rohitgarg025/Intelligent-Humidistat/OUTPUT.jpeg

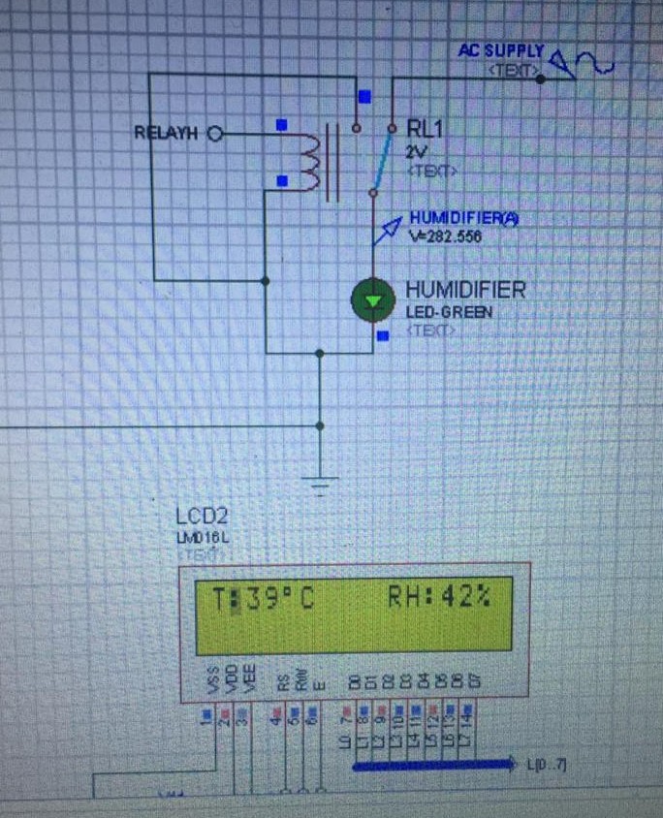
OUTPUT.jpeg
