rohitgarg025/Intelligent-Humidistat/Design.pdf

### Design Components

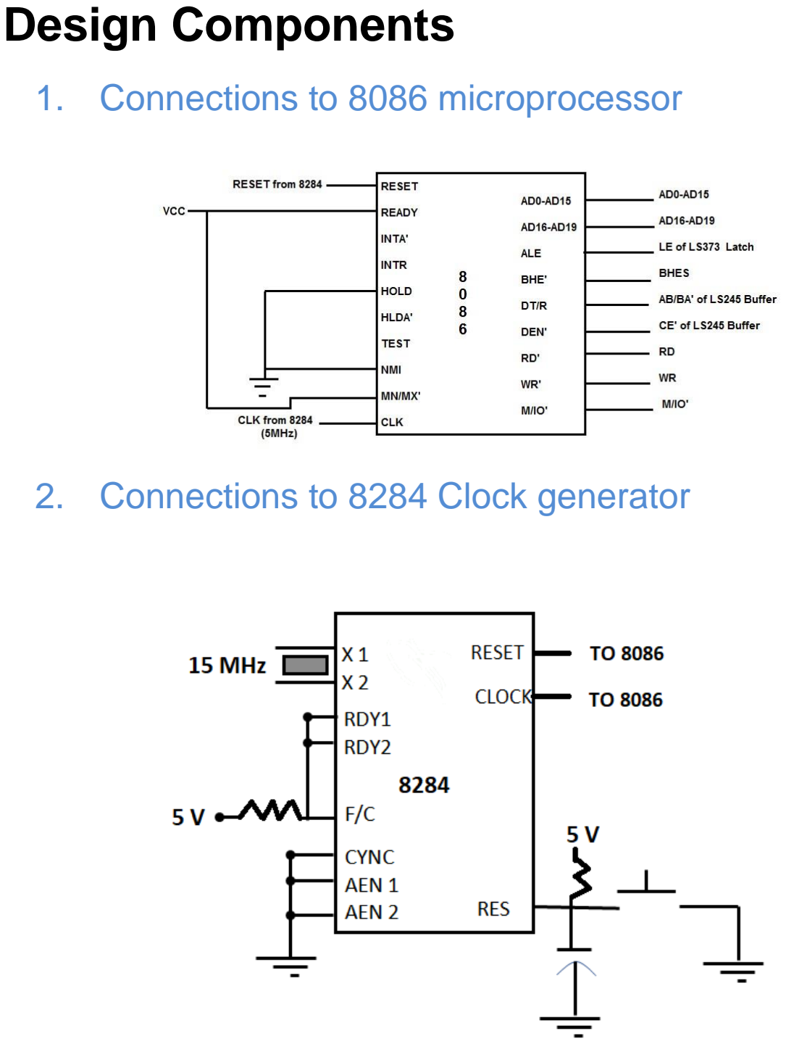
[picture p2: page 1]

1. Connections to 8086 microprocessor
2. Connections to 8284 Clock generator

3. Address Bus : Connections to 74LS373 Octal Latches

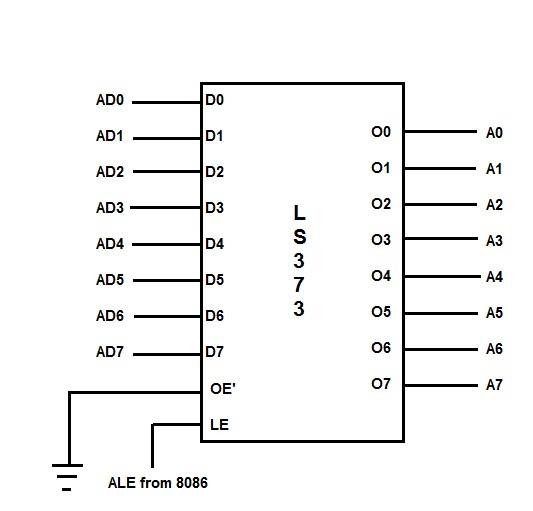
[picture p3: figure]

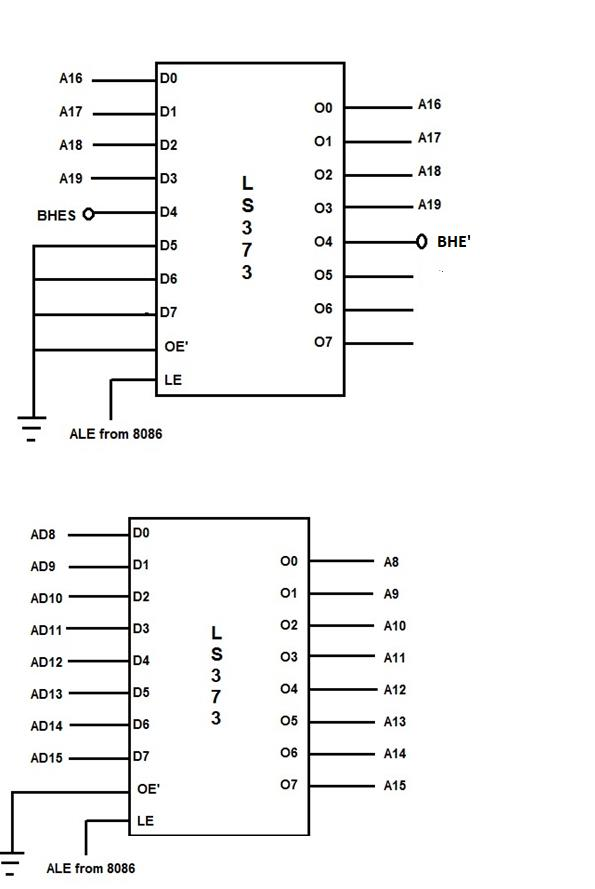
[picture p4: figure]

4. Data Bus : Connections to 74LS245 Octal Buffers

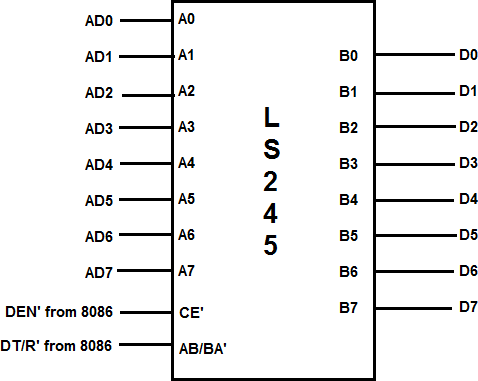
[picture p5: figure]
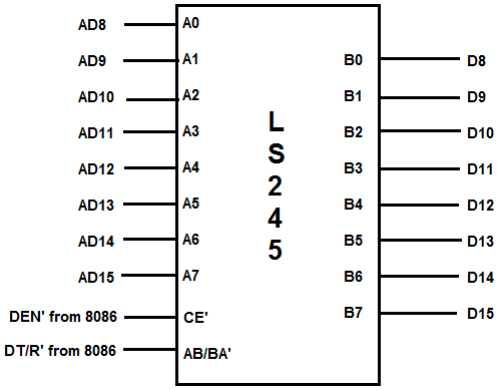
[picture p6: figure]

5. Memory Decoding Logic

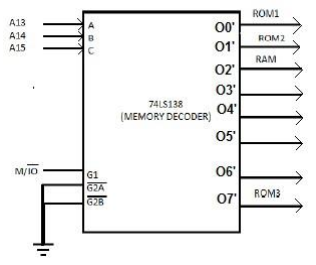
[picture p7: figure]

6. I/O Decoding Logic

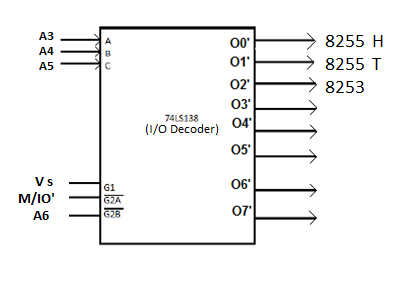
[picture p8: figure]
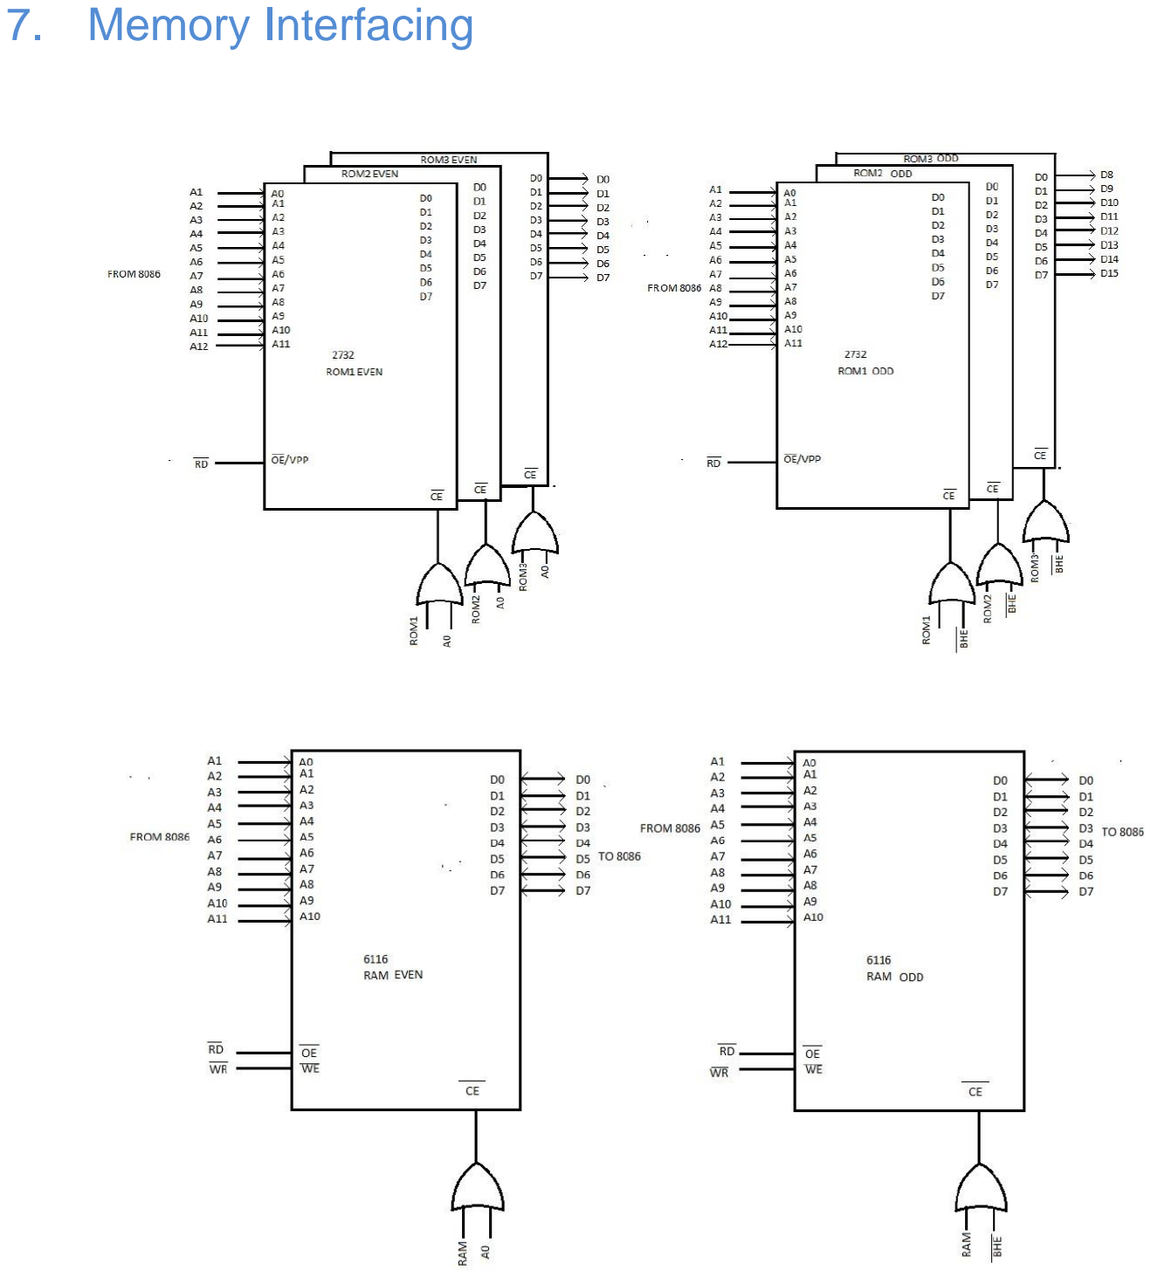
[picture p9: page 6]

7. Memory Interfacing

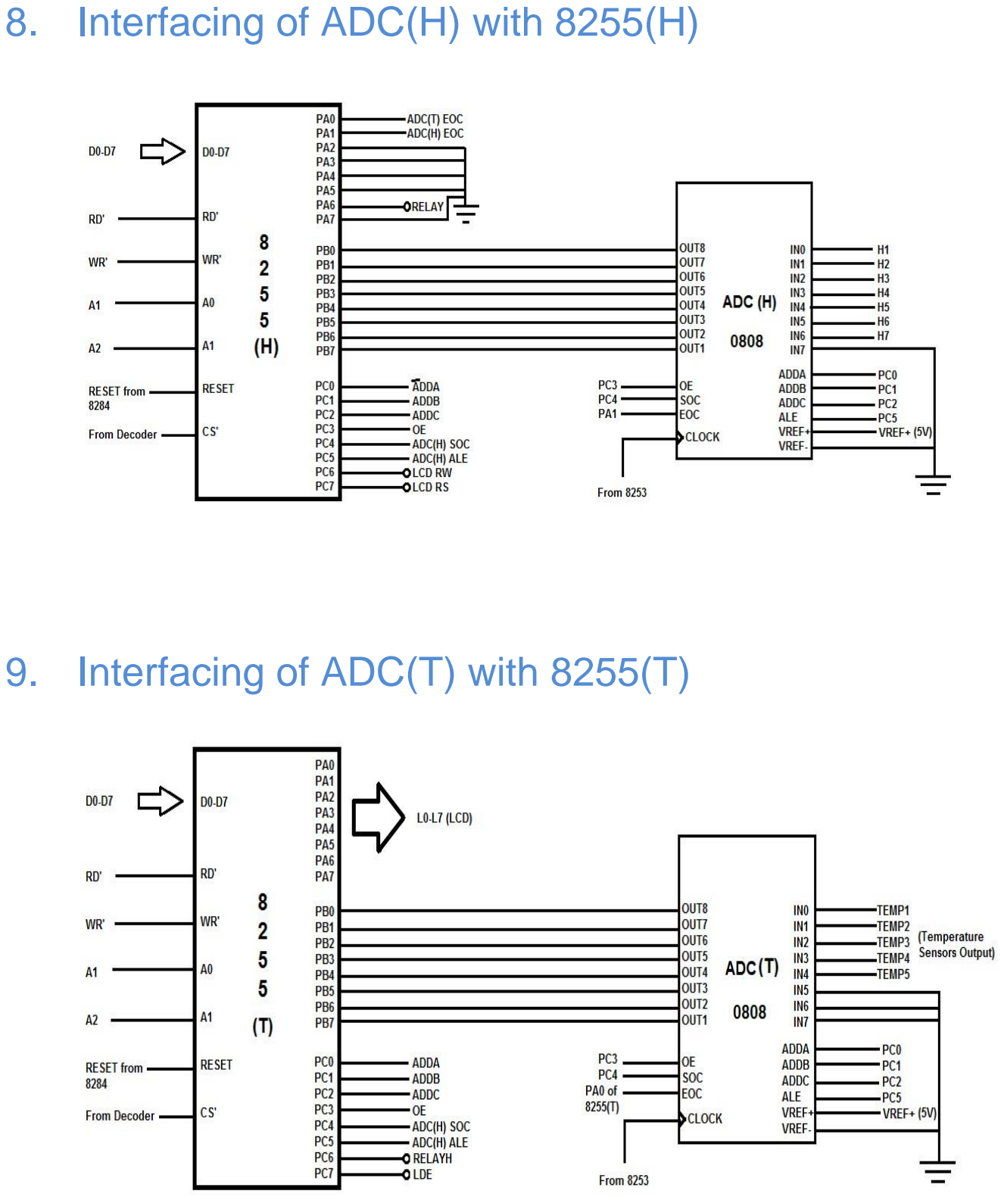
[picture p10: page 7]

8. Interfacing of ADC(H) with 8255(H)
9. Interfacing of ADC(T) with 8255(T)

10. Interfacing of 8253 with ADC0808(T) and ADC0808(H)

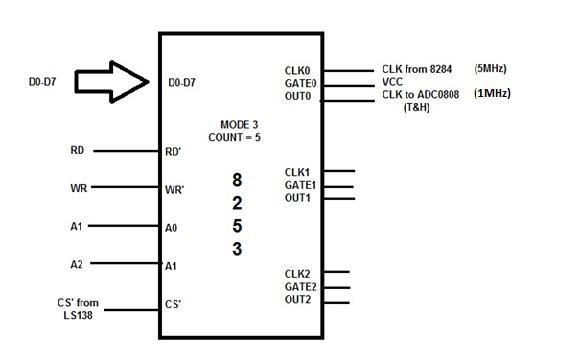
[picture p11: figure]

11. Connections to Temperature sensor LMT85 and Humidity sensor HIH4030

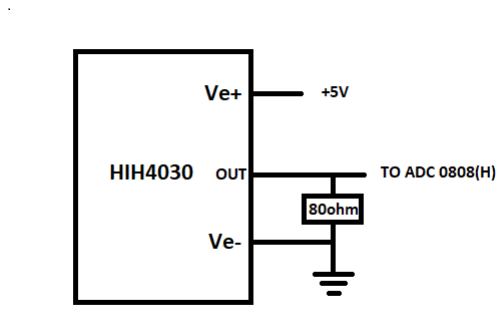
[picture p12: figure]
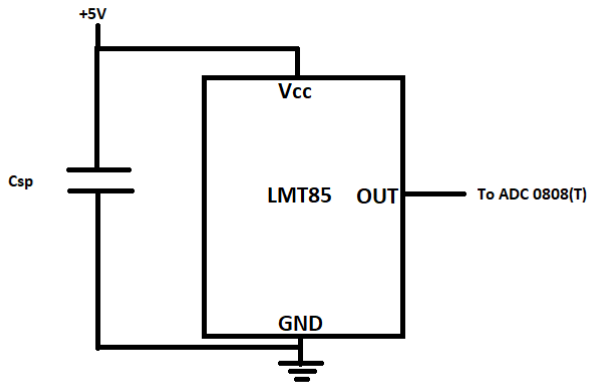
[picture p13: figure]

12. Interfacing of LCD with 8255(H) and 8255 (T)

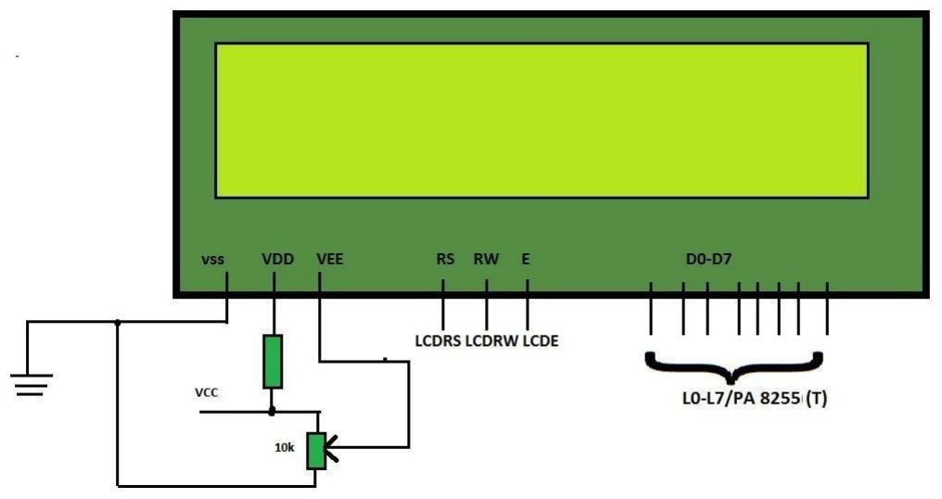
[picture p14: figure]

13. Simple Relay Interfaced with RELAYH(PC6) from 8255 (T)

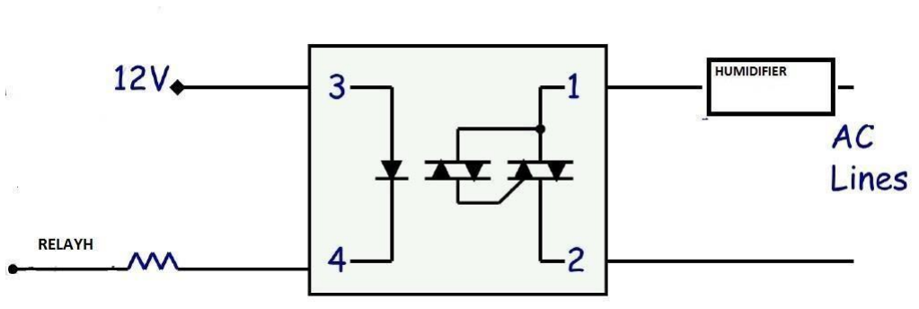
[picture p15: figure]
