rohitgarg025/Intelligent-Humidistat/(list of files, drawings)

Other design files:
IH.DSN
